aquaNeosIN/eyeballer-seeker/hardware/pcb-bottom.png

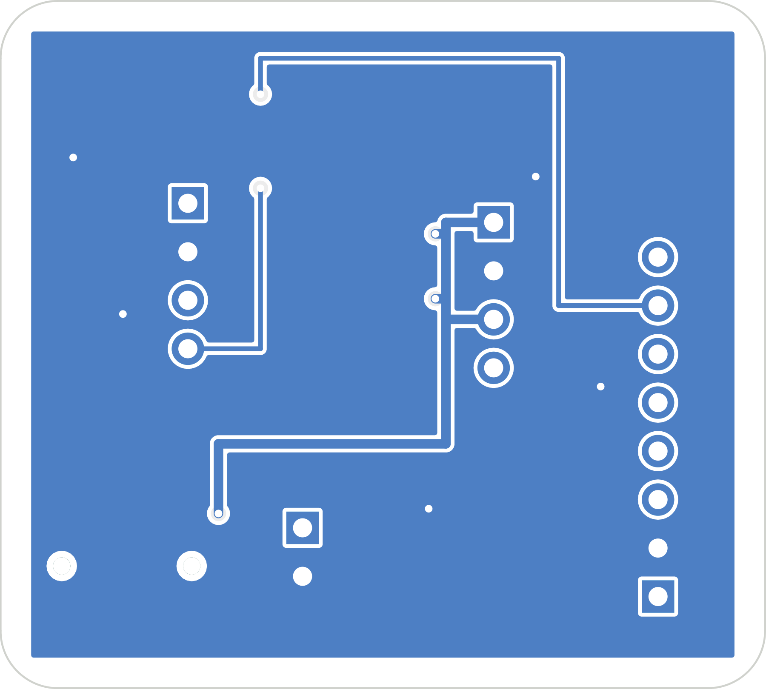
hardware/pcb-bottom.png
