aquaNeosIN/eyeballer-seeker/hardware/pcb-top.png

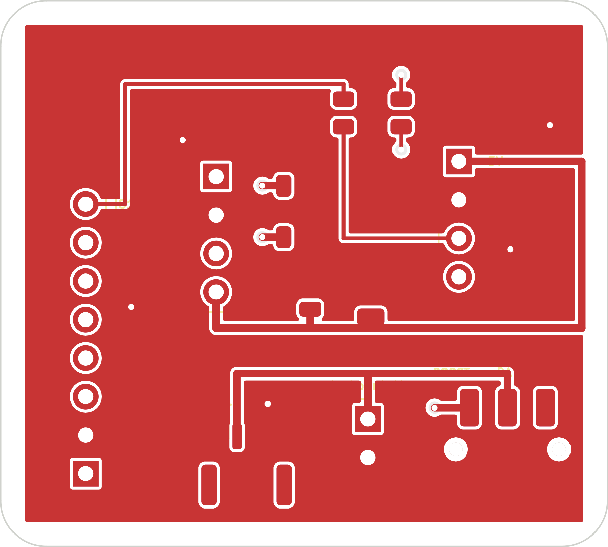
hardware/pcb-top.png
