aquaNeosIN/eyeballer-seeker/hardware/schematic.png

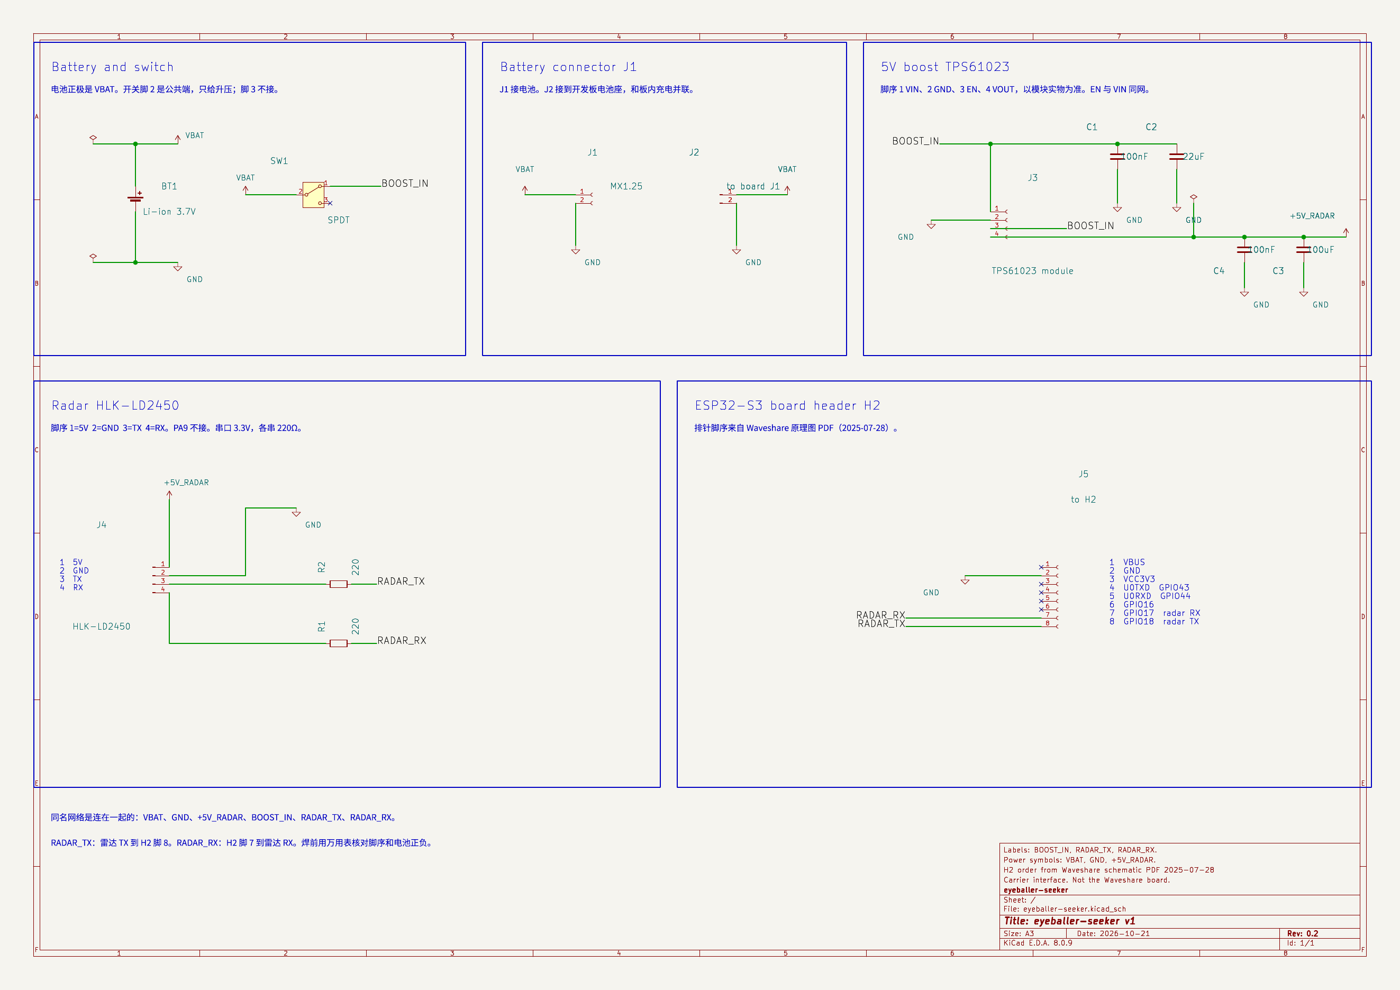
hardware/schematic.png
