aquaNeosIN/eyeballer-seeker/hardware/schematic.pdf

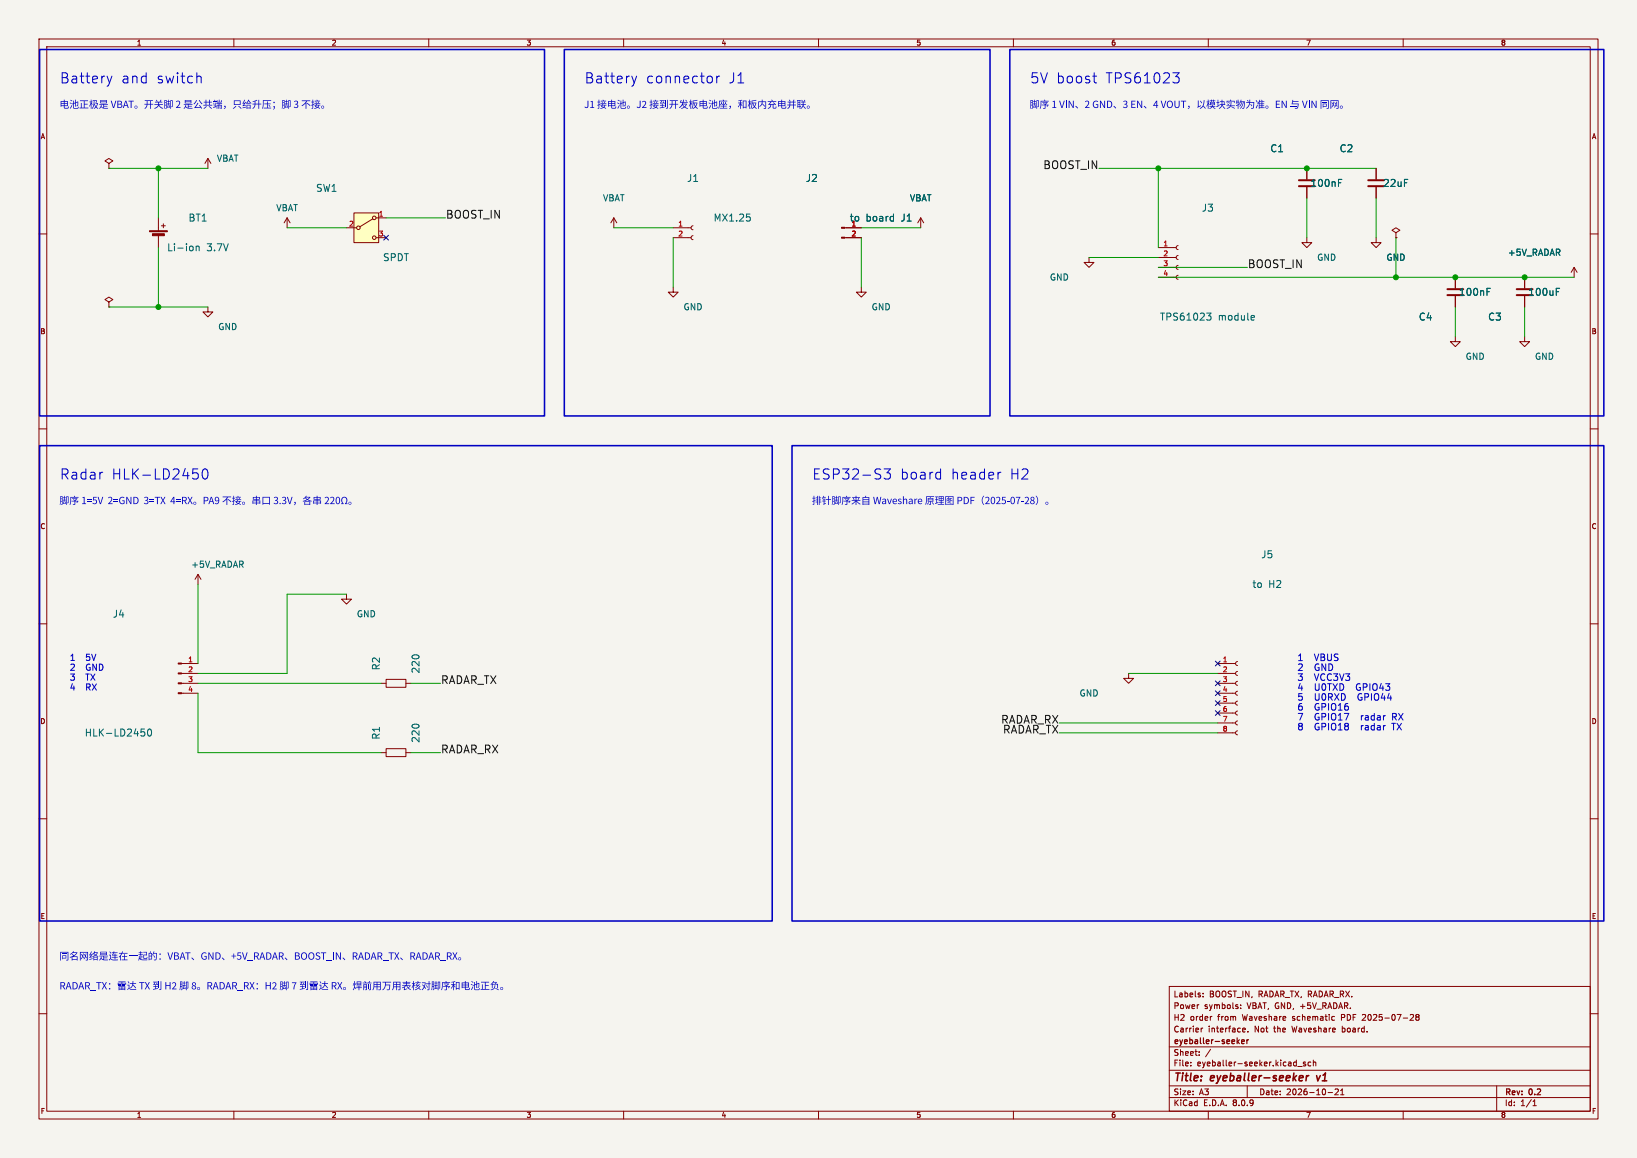
[picture p5: page 1]

_Qs• 2 þÿf/QlQqzïÿSê~ÙSGS‹ÿ•3 þÿN

þÿ•^•1 þÿVIN02 þÿGND03 þÿEN04 þÿVOUTÿNåj!WW[žriN:QÆ0-

þÿ•^•1=5V 2=GND 3=TX þÿ4=RX0-

þÿc’”ˆ•^•ge•ê Waveshare þÿSŸtVþþÿPDFÿ2025-07-28ÿ 0-

þÿRADAR_TXÿ–÷•¾ TXþÿR0H2 þÿ•þÿ80-
