aquaNeosIN/eyeballer-seeker/hardware/eyeballer-seeker.kicad_pcb

## KiCad design hardware/eyeballer-seeker.kicad_pcb (2026-10-21)

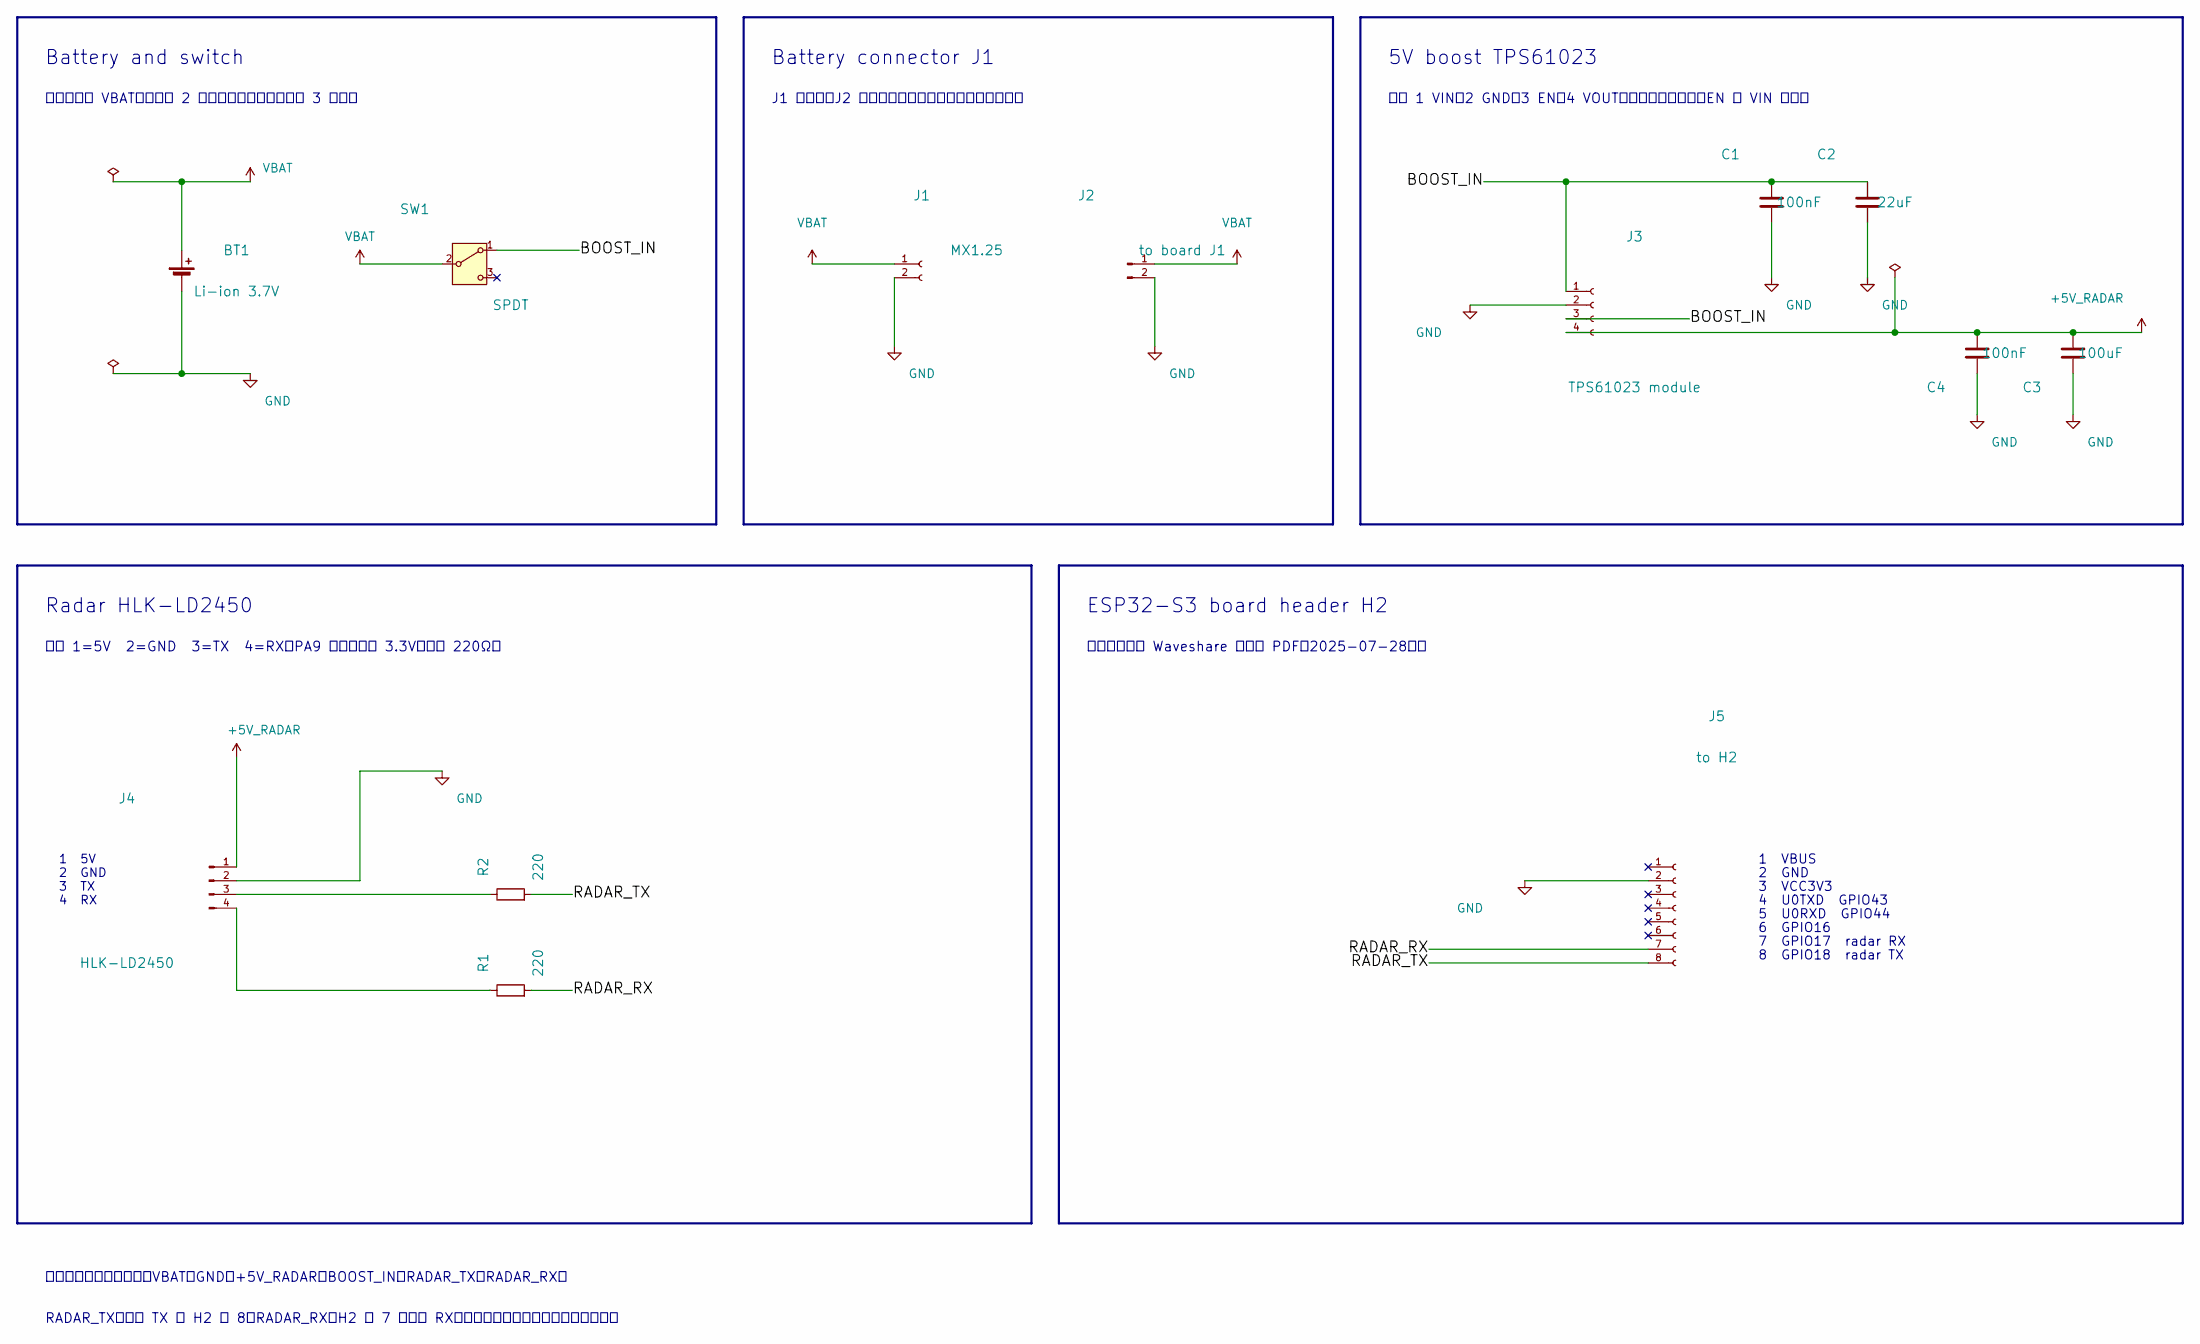
[picture p6: schematic eyeballer-seeker.kicad_sch, eyeballer-seeker v1]

Parts:
BT1: Li-ion 3.7V
C1, C4: 100nF; C_0805_2012Metric
C2: 22uF; C_0805_2012Metric
C3: 100uF; C_1206_3216Metric
J1: MX1.25; JST_GH_SM02B-GHS-TB_1x02-1MP_P1.25mm_Horizontal
J2: to board J1; PinHeader_1x02_P2.54mm_Vertical
J3: TPS61023 module; PinHeader_1x04_P2.54mm_Vertical
J4: HLK-LD2450; PinHeader_1x04_P2.54mm_Vertical
J5: to H2; PinHeader_1x08_P2.54mm_Vertical
R1, R2: 220; R_0805_2012Metric
SW1: SPDT; SW_SPDT_CK_JS102011SAQN

Connections:
+5V_RADAR: C3.1, C4.1, J3.4, J4.1
/BOOST_IN: C1.1, C2.1, J3.1, J3.3, SW1.1 (A)
/RADAR_RX: J5.7, R1.2
/RADAR_TX: J5.8, R2.2
GND: BT1.2 (-), C1.2, C2.2, C3.2, C4.2, J1.2, J2.2, J3.2, J4.2, J5.2
unnamed: J4.3, R2.1
unnamed: J4.4, R1.1
VBAT: BT1.1 (+), J1.1, J2.1, SW1.2 (B)

Notes on the sheet:
Battery and switch
电池正极是 VBAT。开关脚 2 是公共端，只给升压；脚 3 不接。
Battery connector J1
J1 接电池。J2 接到开发板电池座，和板内充电并联。
5V boost TPS61023
脚序 1 VIN、2 GND、3 EN、4 VOUT，以模块实物为准。EN 与 VIN 同网。
Radar HLK-LD2450
脚序 1=5V 2=GND 3=TX 4=RX。PA9 不接。串口 3.3V，各串 220Ω。
ESP32-S3 board header H2
排针脚序来自 Waveshare 原理图 PDF（2025-07-28）。
同名网络是连在一起的：VBAT、GND、+5V_RADAR、BOOST_IN、RADAR_TX、RADAR_RX。
RADAR_TX：雷达 TX 到 H2 脚 8。RADAR_RX：H2 脚 7 到雷达 RX。焊前用万用表核对脚序和电池正负。
1 5V
2 GND
3 TX
4 RX
1 VBUS
3 VCC3V3
4 U0TXD GPIO43
5 U0RXD GPIO44
6 GPIO16
7 GPIO17 radar RX
8 GPIO18 radar TX

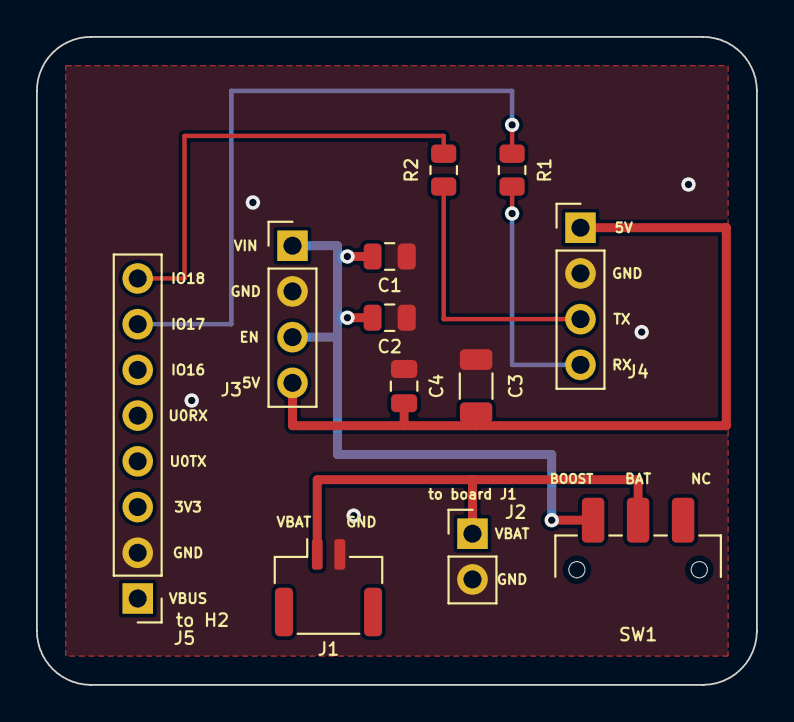
[picture p7: board eyeballer-seeker.kicad_pcb from above]

Board: 2 copper layers, 40.0 x 36.0 mm, 12 parts (0 on the bottom side), 8 nets.
