aquaNeosIN/eyeballer-seeker/(commit log)

2026-10-21 Add the v1 system schematic for the round display and radar.
    Document the Waveshare header, battery tap, and TPS61023 boost in Chinese so the board can be wired before firmware exists.
    [eyeballer-seeker.kicad_sch]
2026-10-21 Redraw the system schematic so each wire lands on a pin.
    Lay the sheet out left to right from the battery to the radar, move the board into the main area, and export a larger drawing plus a module diagram. ERC reports zero errors.
    [eyeballer-seeker.kicad_sch]
2026-10-21 Redraw the schematic in functional blocks and add a first carrier PCB.
    [eyeballer-seeker.kicad_pcb, eyeballer-seeker.kicad_sch]
2026-10-21 Add ESP-IDF firmware that drives the round display from the radar.
    FreeRTOS tasks parse the LD2450, read the IMU, pick a gaze target, and draw the face. SIMULATE_RADAR is on by default so the first flash moves the eyes without the module.
    [partitions.csv]
2026-10-21 Rewrite the project README as an introduction and add an MIT license.
    Move the wiring notes and the bring-up checklist into hardware/README.md so the front page stays a short description of the watch.
